WPIRoboticsProjects/Lionfish-AcousticLink/readme.md

This is the repo for acoustic modem and localization from acoustic modem
