WPIRoboticsProjects/Lionfish-AcousticLink/TransPowerCalculation/Marsh and Schulkin absorbation.png

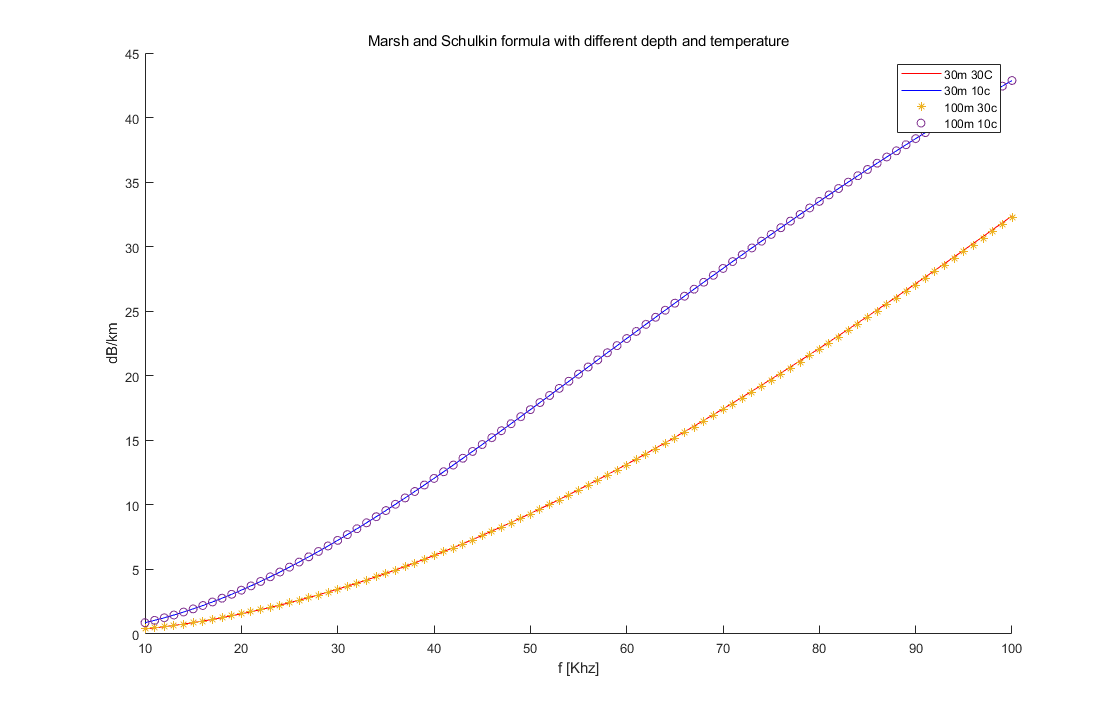
TransPowerCalculation/Marsh and Schulkin absorbation.png
