WPIRoboticsProjects/Lionfish-AcousticLink/TransPowerCalculation/Spread loss.png

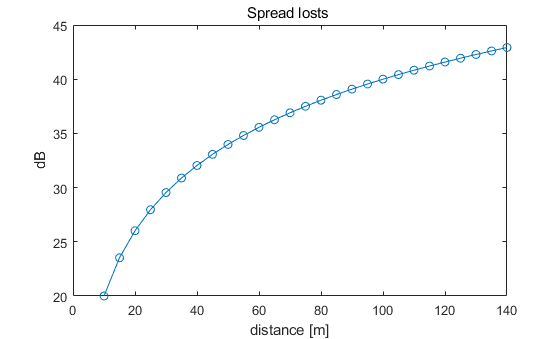
TransPowerCalculation/Spread loss.png
