WPIRoboticsProjects/Lionfish-AcousticLink/TransPowerCalculation/Thorp formula.png

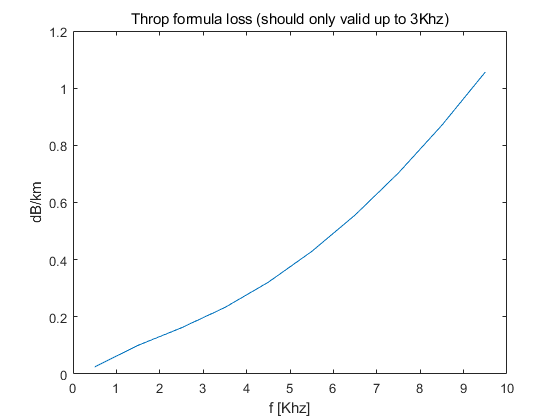
TransPowerCalculation/Thorp formula.png
