WPIRoboticsProjects/Lionfish-AcousticLink/Measurements/Batt flyback nosie.docx

Added highlighted part for gate protection and battery noise filtering.

(gate protection will not work unless there are no spikes in battery voltage).

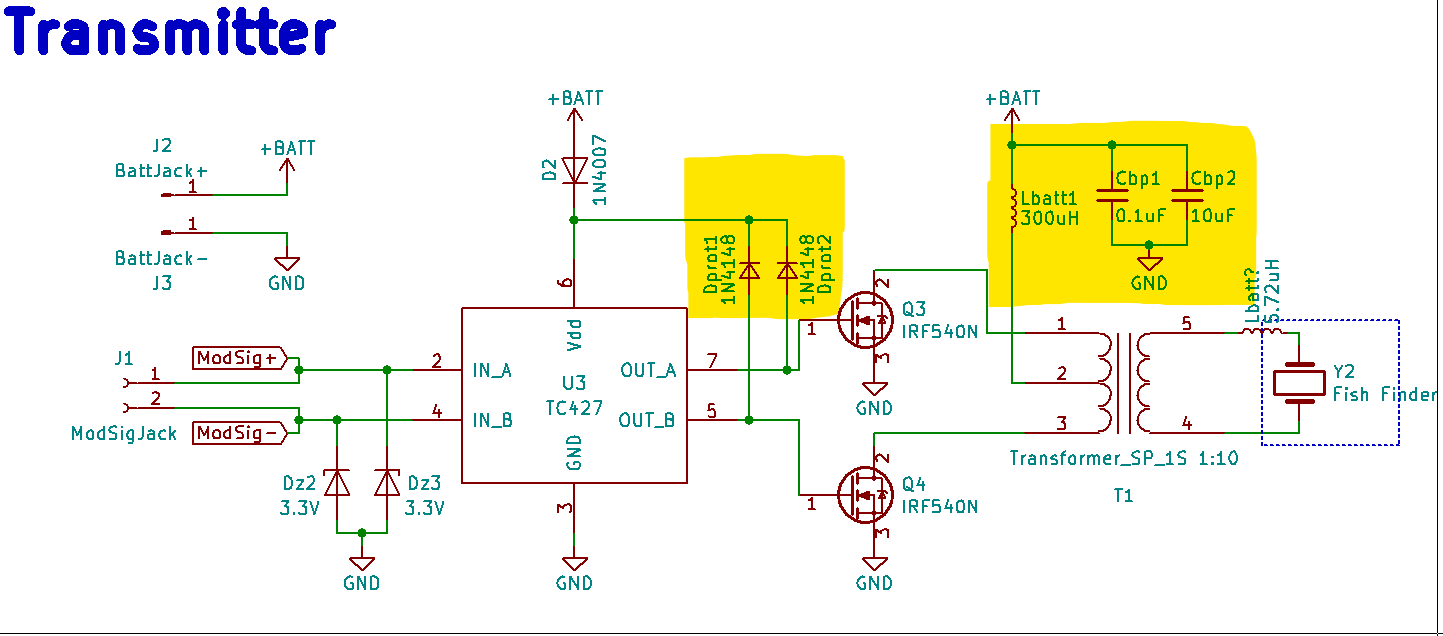
[picture p4: figure]
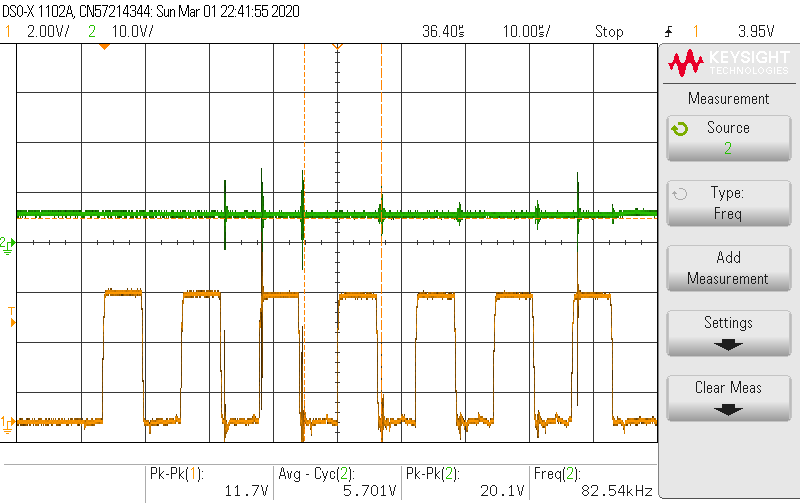
[picture p5: figure]

Orange: Voltage at Gate:

Green: Power supply voltage.
