WPIRoboticsProjects/Lionfish-AcousticLink/Measurements/200Khz HF ring.docx

Driving the setup using Arduino with 5V, 200Khz.

Ch1 is across half a transformer coil, Ch2 is fish finder output

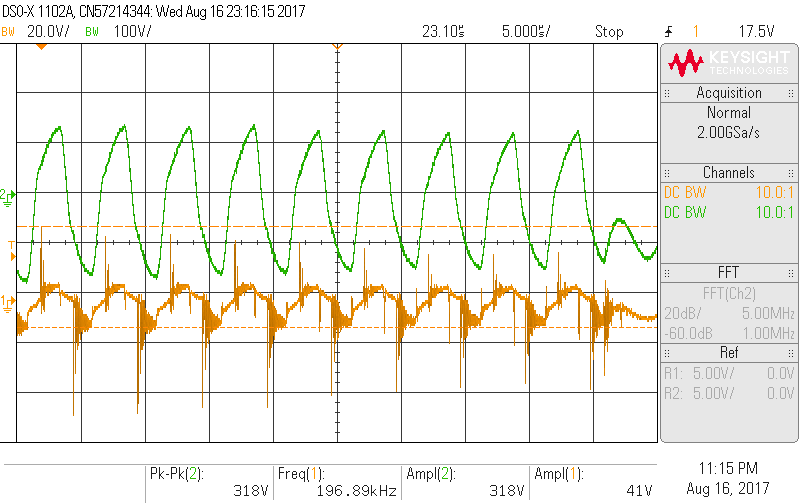
[picture p6: figure]

Zoom in on ring of transformer.

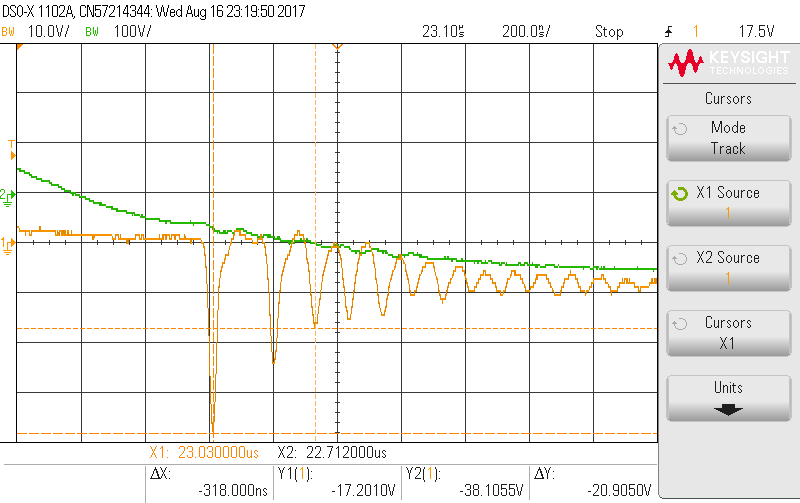
[picture p7: figure]
