WPIRoboticsProjects/Lionfish-AcousticLink/Measurements/Transistor LevelShift fail.docx

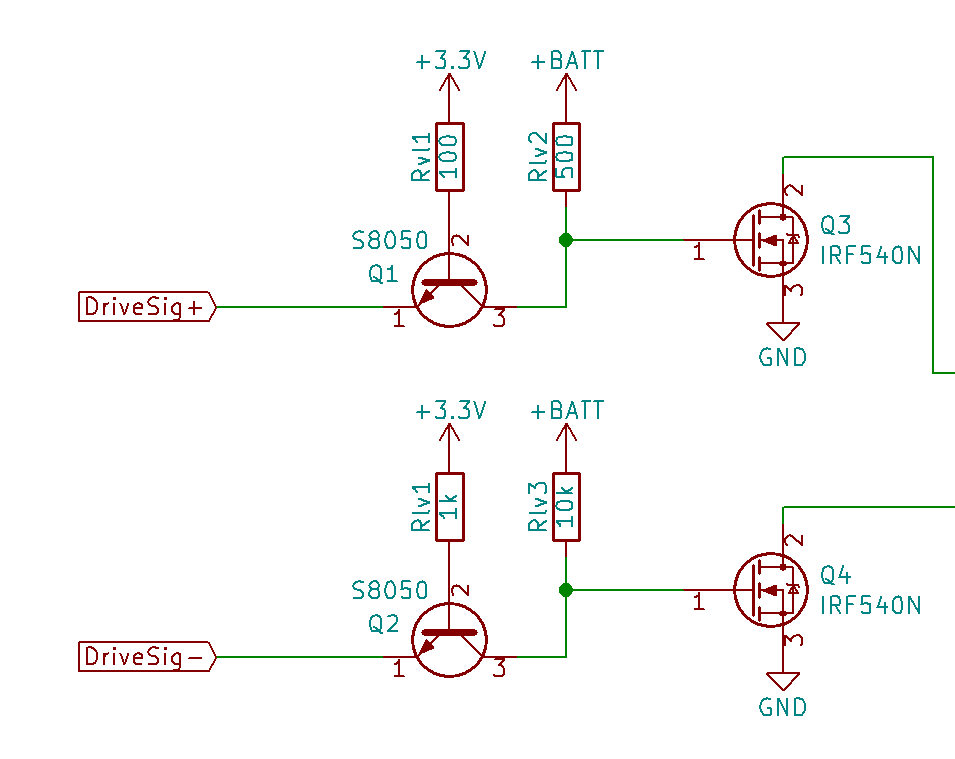
[picture p17: figure]
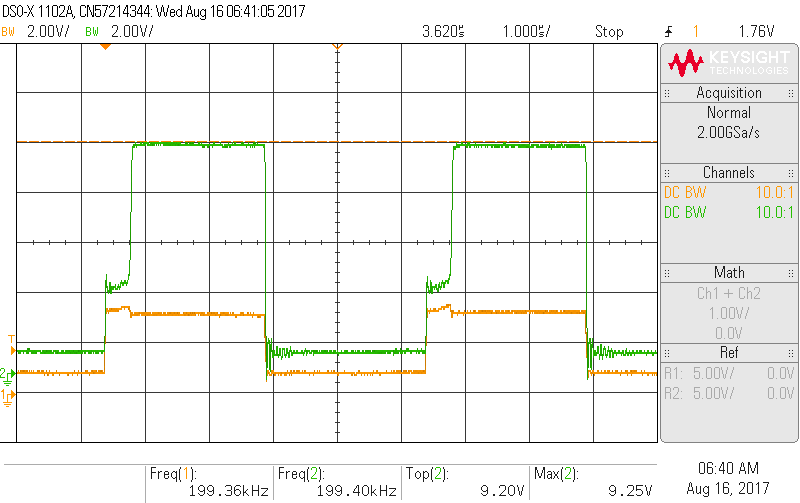
[picture p18: figure]

Notice the 0.6us delay before turn on

When MOSFET is connected (MOSFET is not driving anything)

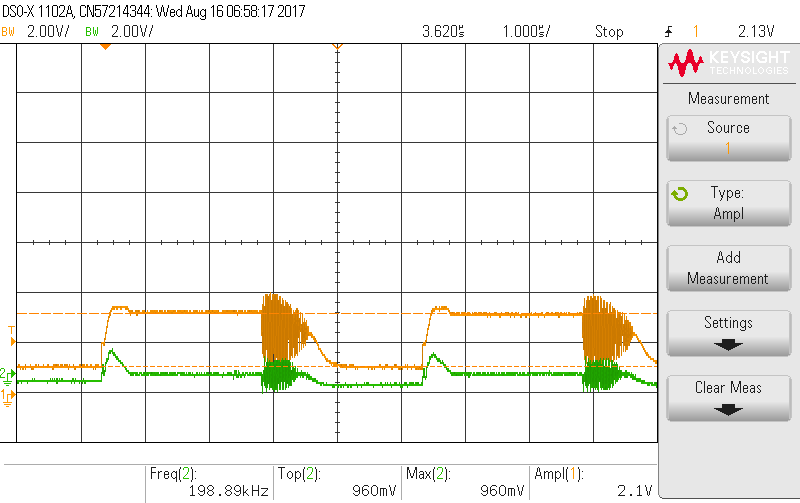
[picture p19: figure]
