WPIRoboticsProjects/Lionfish-AcousticLink/Measurements/Amplifiers/Amplifier Noise.docx

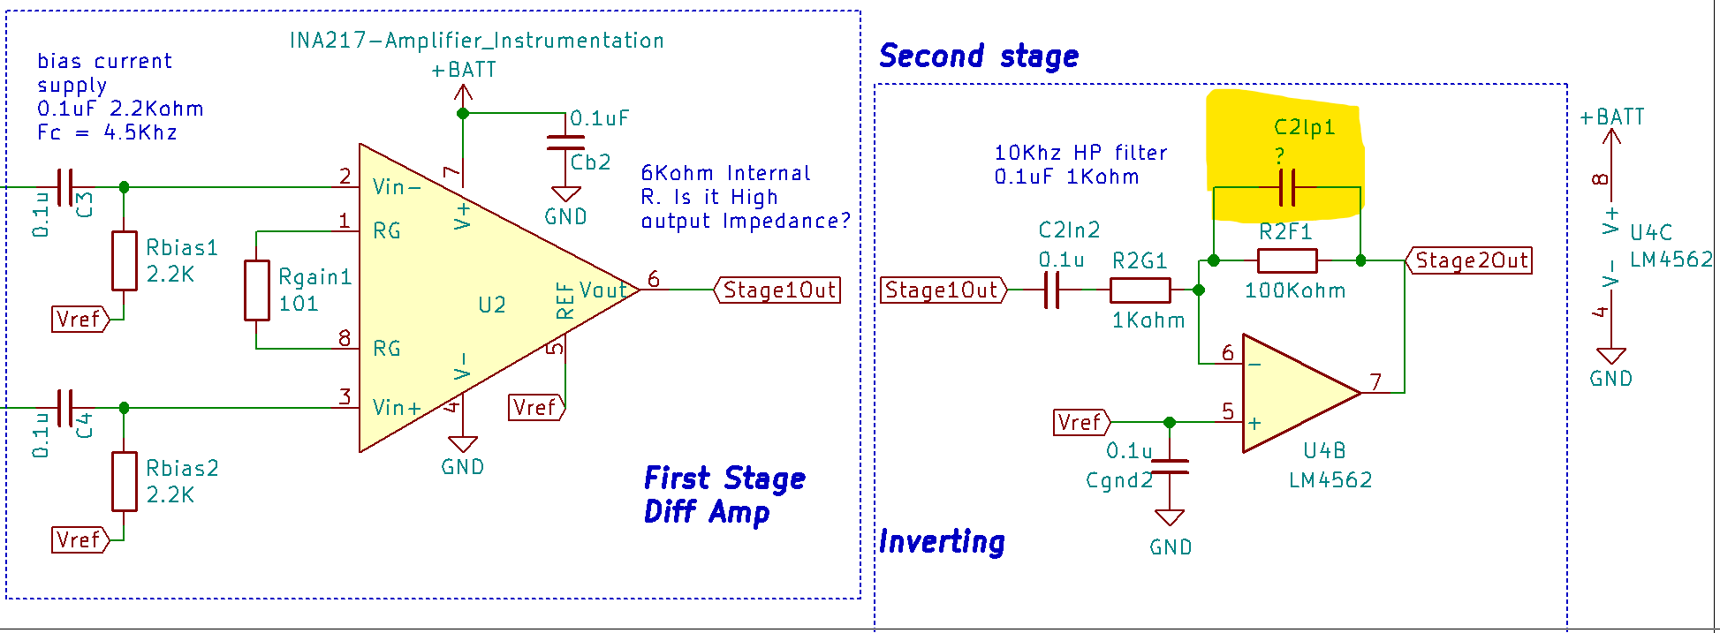
[picture p20: figure]

The first waveform is without C2lp1 cap

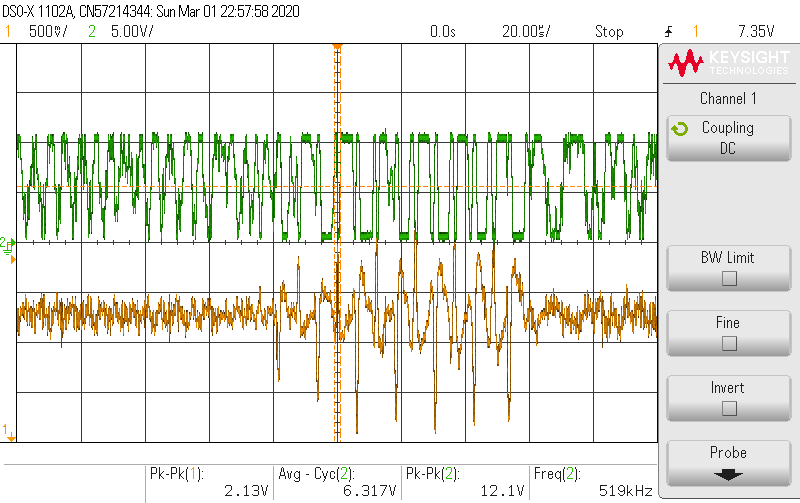
[picture p21: figure]

Orange: first stage output,

Green: second stage output.

The signal is still noticeable as they are fully saturated. But only to human eyes.

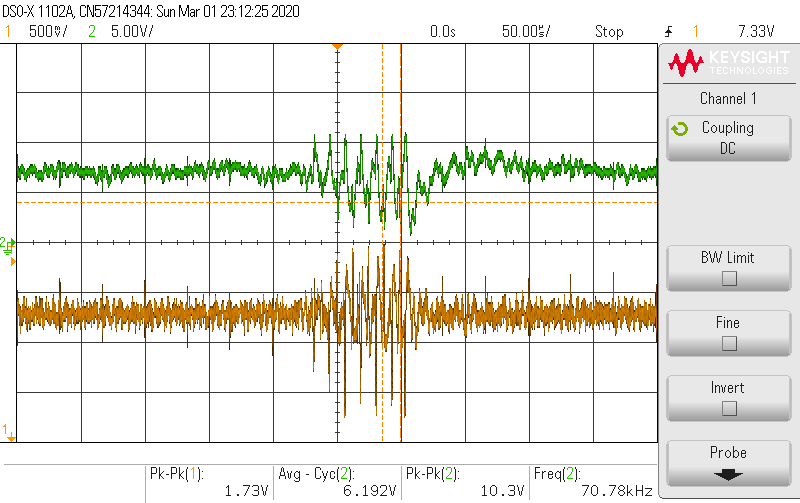
[picture p22: figure]

With C2lp1 = 100pF.

The noise is suppressed (not much), but the output signal is also suppressed by 10 times. (suppose to be 100 times gain).
