WPIRoboticsProjects/Lionfish-AcousticLink/Measurements/Powersupply/Transient Flyback Batt.csv

x-axis | 1 | 2
second | Volt | Volt
-61.600E-06
-61.500E-06 | -49.245978E-03 | +5.910804018E+00
-61.400E-06 | -69.346480E-03 | +5.910804018E+00
-61.300E-06 | -39.195727E-03 | +5.920854270E+00
-61.200E-06 | -39.195727E-03 | +5.991206028E+00
-61.100E-06 | -69.346480E-03 | +5.940954772E+00
-61.000E-06 | -39.195727E-03 | +5.961055274E+00
-60.900E-06 | -69.346480E-03 | +5.830402009E+00
-60.800E-06 | -39.195727E-03 | +5.910804018E+00
-60.700E-06 | -19.095224E-03 | +5.910804018E+00
-60.600E-06 | -69.346480E-03 | +5.739949749E+00
-60.500E-06 | -69.346480E-03 | +5.729899498E+00
-60.400E-06 | -69.346480E-03 | +5.830402009E+00
-60.300E-06 | -99.497234E-03 | +5.910804018E+00
-60.200E-06 | -99.497234E-03 | +5.961055274E+00
-60.100E-06 | -49.245978E-03 | +5.910804018E+00
-60.000E-06 | -69.346480E-03 | +5.830402009E+00
-59.900E-06 | -19.095224E-03 | +5.910804018E+00
-59.800E-06 | -39.195727E-03 | +5.860552763E+00
-59.700E-06 | -39.195727E-03 | +5.910804018E+00
-59.600E-06 | -99.497234E-03 | +5.910804018E+00
-59.500E-06 | -39.195727E-03 | +5.910804018E+00
-59.400E-06 | -69.346480E-03 | +5.910804018E+00
-59.300E-06 | -19.095224E-03 | +5.910804018E+00
-59.200E-06 | -39.195727E-03 | +5.880653265E+00
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
