WPIRoboticsProjects/Lionfish-AcousticLink/TransPowerCalculation/Impedance Cal/Fish and coil Impedance Measure.xlsx

Sheet: Fish Finder Impedance
Fig 1 Circuit |  |  |  | Voltage -> current phase
Feq (Khz) | Vfish (Prob2-Gnd) Vpp (V) | Vr (Prob1-Prob2) Vpp | Current (Vr/R) (A) | Vfish -> Ifish angle (deg) | V/I | Re{z} | Im{z}
300 | 3.47 | 8.72 | 0.00872 | -89.2 | 397.936 | 5.557 | -397.897
250 | 4.3 | 7.95 | 0.00795 | -80.1 | 540.881 | 92.994 | -532.826
225 | 4.362 | 8.15 | 0.00815 | -86.1 | 535.215 | 36.403 | -533.975
210 | 4.58 | 7.074 | 0.007074 | -71.1 | 647.441 | 209.718 | -612.535
205 | 3.956 | 7.411 | 0.007411 | -69.5 | 533.801 | 186.942 | -499.996
200 | 3.77 | 7.93 | 0.00793 | -75.52 | 475.410 | 118.873 | -460.308
195 | 4.139 | 8.074 | 0.008074 | -82.7 | 512.633 | 65.138 | -508.478
190 | 4.404 | 7.969 | 0.007969 | -83.8 | 552.641 | 59.686 | -549.409
175 | 4.71 | 7.88 | 0.00788 | -84.09 | 597.716 | 61.545 | -594.539
150 | 5.7 | 7.53 | 0.00753 | -83.88 | 756.972 | 80.703 | -752.658
130
120 | 6.21 | 7.08 | 0.00708 | -84.46 | 877.119 | 84.679 | -873.022
110
100 | 7.38 | 6.01 | 0.00601 | -87.5 | 1227.953 | 53.564 | -1226.785
90 | 8.01 | 4.89 | 0.00489 | -84.58 | 1638.037 | 154.724 | -1630.713
85 | 8.28 | 3.79 | 0.00379 | -76.76 | 2184.697 | 500.365 | -2126.625
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
