WPIRoboticsProjects/Lionfish-AcousticLink/Measurements/100 10K Rtrans .jpg

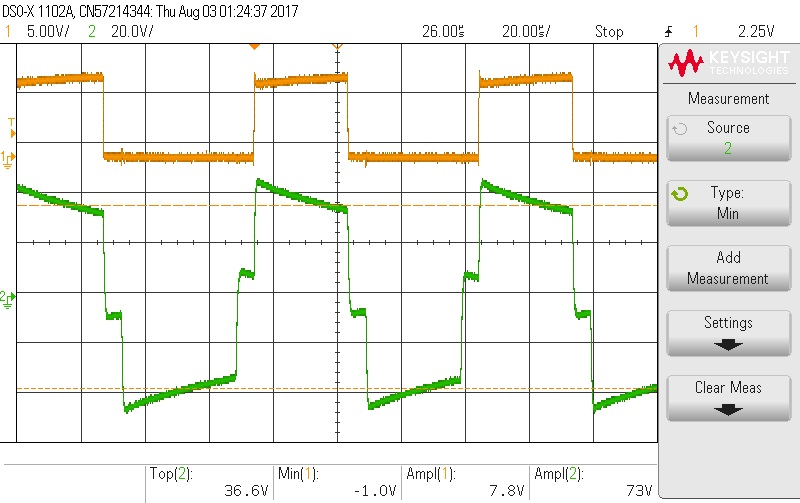
Measurements/100 10K Rtrans .jpg
