WPIRoboticsProjects/Lionfish-AcousticLink/Measurements/100 100K real trans.jpg

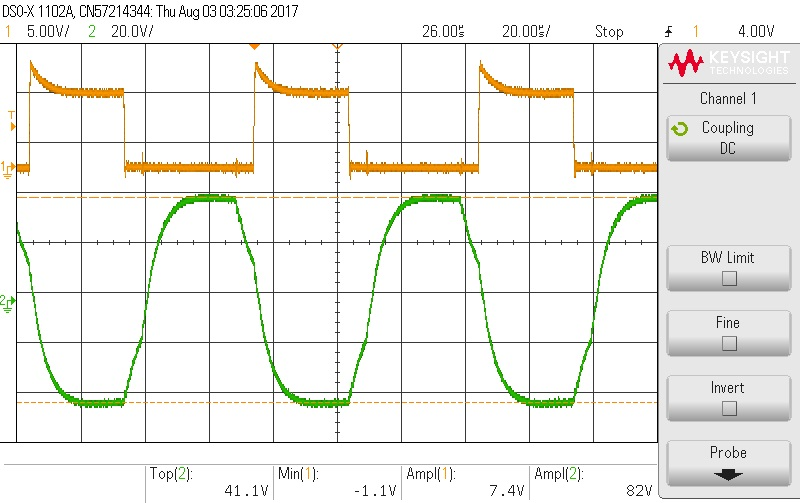
Measurements/100 100K real trans.jpg
