WPIRoboticsProjects/Lionfish-AcousticLink/Measurements/100 100K Rtrans.jpg

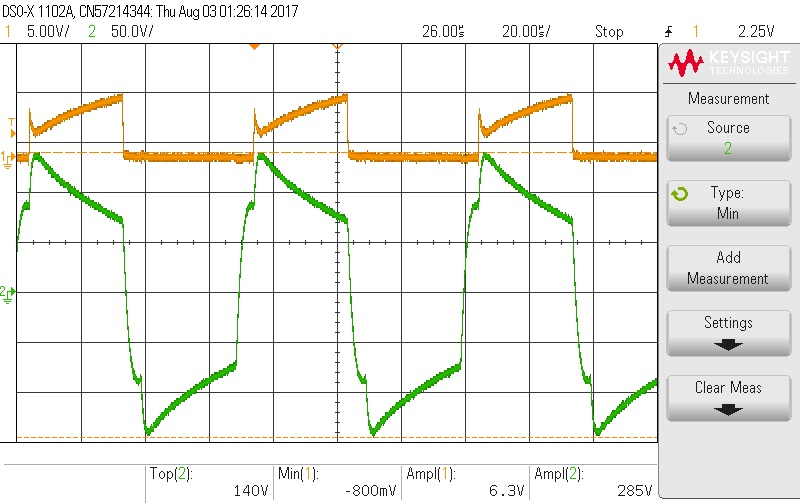
Measurements/100 100K Rtrans.jpg
