WPIRoboticsProjects/Lionfish-AcousticLink/TransducerDriver/TransReceiver.pdf

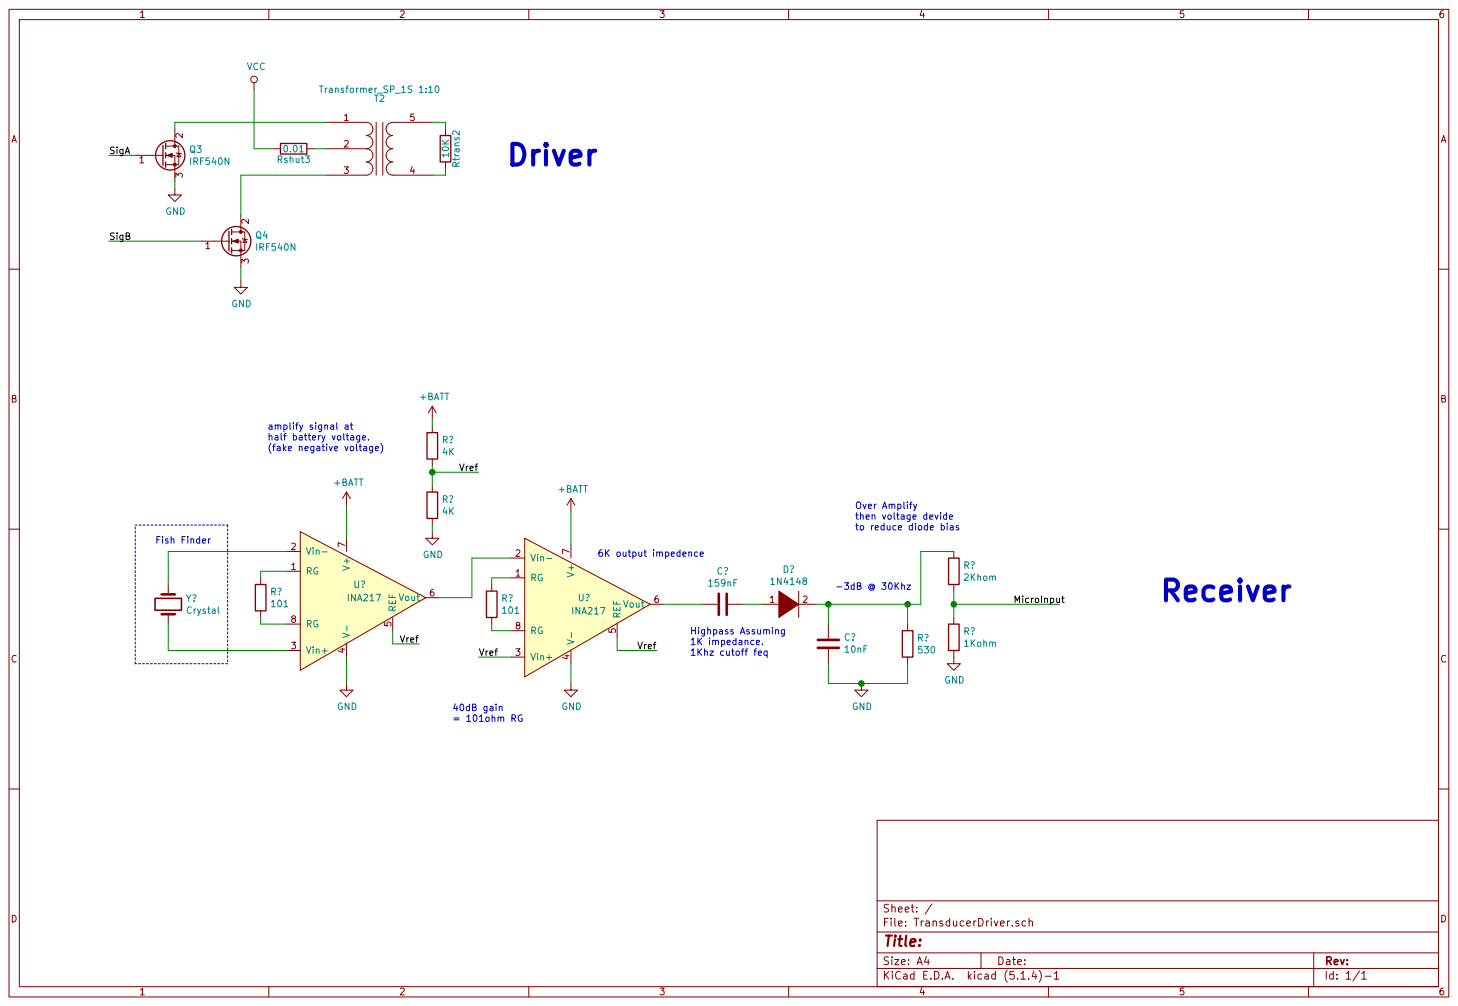
[picture p26: page 1]

Vref Vref Vref SigB
4K GND

Id: 1/1 Title: File: TransducerDriver.sch Sheet: / R?

6K output impedence Fish Finder
