WPIRoboticsProjects/Lionfish-AcousticLink/(list of files, drawings)

Other design files:
TransducerDriver/Clamper.ms14
TransducerDriver/Envelop Detector/EnvelopDetector Simulation.ms14
