WPIRoboticsProjects/Lionfish-AcousticLink/TransducerDriver/TransducerDriver.kicad_pcb

## KiCad design TransducerDriver/TransducerDriver.kicad_pcb (2020-02-15)

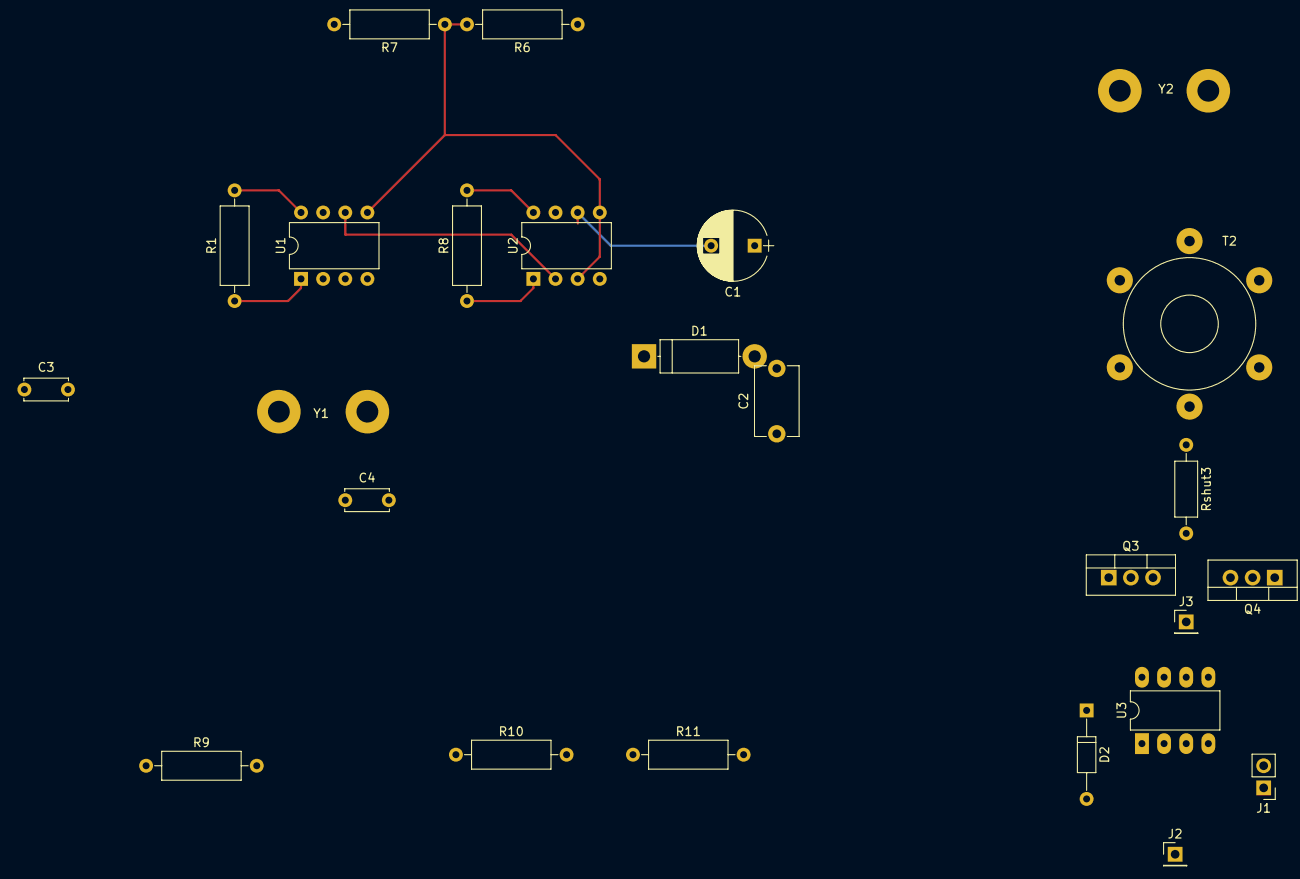
[picture p27: board TransducerDriver.kicad_pcb from above]

Board: 2 copper layers, 25 parts (0 on the bottom side), 26 nets.

Parts:
C1: 159nF; CP_Radial_D8.0mm_P5.00mm
C2: 10nF; C_Disc_D8.0mm_W5.0mm_P7.50mm
C3, C4: 0.1u; C_Disc_D5.0mm_W2.5mm_P5.00mm
D1: 1N4148; D_5W_P12.70mm_Horizontal
D2: 1N4007; D_DO-35_SOD27_P10.16mm_Horizontal
J1: ModSigJack; Pin_Header_Straight_1x02_Pitch2.54mm
J2, J3: BattJack; Pin_Header_Straight_1x01_Pitch2.54mm
Q3, Q4: IRF540N; TO-220-3_Vertical
R1, R8: 101; R_Axial_DIN0309_L9.0mm_D3.2mm_P12.70mm_Horizontal
R6, R7: 4K; R_Axial_DIN0309_L9.0mm_D3.2mm_P12.70mm_Horizontal
R9: 530; R_Axial_DIN0309_L9.0mm_D3.2mm_P12.70mm_Horizontal
R10: 2Khom; R_Axial_DIN0309_L9.0mm_D3.2mm_P12.70mm_Horizontal
R11: 1Kohm; R_Axial_DIN0309_L9.0mm_D3.2mm_P12.70mm_Horizontal
Rshut3: 0.01; R_Axial_DIN0207_L6.3mm_D2.5mm_P10.16mm_Horizontal
T2: Transformer_SP_1S 1:10; Transformer_Toroid_Tapped_Horizontal_D14.0mm_Amidon-T50
U1, U2: INA217; DIP-8_W7.62mm
U3: TC427; DIP-8_W7.62mm_LongPads
Y1, Y2: Crystal; WireConnection_2.50mmDrill

Connections:
+BATT: D2.2, J2.1, R6.1, Rshut3.2, U1.7, U2.7
/MicroInput: R10.2, R11.1
/Vref: R6.2, R7.1, U1.5, U2.3, U2.5
GND: C2.1, J3.1, Q3.3, Q4.3, R7.2, R9.2, R11.2, U1.4, U2.4, U3.3
ModSig+: J1.1, U3.2
ModSig-: J1.2, U3.4
unnamed: C1.1, D1.1
unnamed: C1.2, U2.6
unnamed: C2.2, D1.2, R9.1, R10.1
unnamed: C3.1, U1.2
unnamed: C3.2, Y1.1
unnamed: C4.1, U1.3
unnamed: C4.2, Y1.2
unnamed: D2.1, U3.6
unnamed: Q3.1, U3.7
unnamed: Q3.2, T2.1
unnamed: Q4.1, U3.5
unnamed: Q4.2, T2.3
unnamed: R1.1, U1.1
unnamed: R1.2, U1.8
unnamed: R8.1, U2.1
unnamed: R8.2, U2.8
unnamed: Rshut3.1, T2.2
unnamed: T2.4, Y2.2
unnamed: T2.5, Y2.1
unnamed: U1.6, U2.2
