WPIRoboticsProjects/Lionfish-AcousticLink/ArmTransceive/pwmDriver.h

/*
 * pwmDriver.h
 *
 *  Created on: 2020��2��3��
 *      Author: leogr
 */

#ifndef PWMDRIVER_H_
#define PWMDRIVER_H_

void pwm1Init();
void pwm3Init();
void pwmPinInit();
void pwmOutputEnable();
void pwmOutputDisable();

void TXdebugPinSet(uint8_t data);
void TXdebugPinInit();

void PWM_ISR_FUNC(void);



#endif /* PWMDRIVER_H_ */
