WPIRoboticsProjects/Lionfish-AcousticLink/ArmTransceive/TimerTX.h

/*
 * TimerTX.h
 *
 *  Created on: 2020Äê2ÔÂ23ÈÕ
 *      Author: leogr
 */

#ifndef TIMERTX_H_
#define TIMERTX_H_


void t1OF_ISR();
void timer1Init();



extern uint16_t t1OFCount ;


#endif /* TIMERTX_H_ */
