WPIRoboticsProjects/Lionfish-AcousticLink/(commit log)

2019-10-29 Made waveform gen for any sample rate and base frequency
2019-11-07 created Matlab calculation for transmission loss, and attached figure for result from different method
2019-11-07 added design for switching battery
    [BatRelay.kicad_pcb, BatRelay.sch]
2019-11-07 added ESD zener for MOSFET design
    [BatRelay.sch]
2019-11-07 Revert "Merge branch 'master' of https://github.com/LionfishMQP/AcousticLink"
    This reverts commit a923de0f6f5281807e581be3a9d295d99ad474c0, reversing
    changes made to ccfcc6052f2c2148d2317a675659a02fa5cdc53d.
    [BatRelay.kicad_pcb, BatRelay.sch]
2019-11-07 Revert "Revert "Merge branch 'master' of https://github.com/LionfishMQP/AcousticLink""
    This reverts commit bcc0f9a52feea505232c62d8da3853226641cb11.
    [BatRelay.kicad_pcb, BatRelay.sch]
2019-11-12 added design for distributed power cycle
    [BatRelay.kicad_pcb, BatRelay.sch, PowerDistribution.kicad_pcb, PowerDistribution.sch]
2019-11-30 created basic decoding file, and added csv write to matlab
    [processedSamples.csv, samples.csv]
2019-12-03 OOK Modulation + Cleanup
    Added modulation + writing to csv in encode.c
    Organized python and c file folders
    [encode_payload.csv, encoded_payload.csv]
2019-12-04 finished ook modulation to csv
    [encode_payload.csv, encoded_binary.csv, encoded_payload.csv, modulated_binary.csv]
2019-12-04 encode fix
    [encoded_binary.csv, modulated_binary.csv]
2019-12-04 new SAMPLE_RATE
    [encoded_binary.csv, modulated_binary.csv]
2019-12-05 changed filter range
2019-12-09 fixes + settings (WIP)
    [modulated_binary.csv, processedSamples.csv, settings.csv]
2020-02-03 PWM driver on arm board, transducer circuit
    [BatRelay.kicad_pcb, BatRelay.sch, PowerDistribution.kicad_pcb, PowerDistribution.sch, TransducerDriver.kicad_pcb, TransducerDriver.sch]
2020-02-10 changes
    sampling adc + buttons
2020-02-15 updates
    compiles for me now, added support for buttons and sampling .c
2020-02-15 studies on transducer
    [Fishfinder Impedance Measure.xlsx, TransducerDriver.kicad_pcb, TransducerDriver.sch]
2020-02-16 small change on InsAmp. Input pull to vref
    [TransducerDriver.sch]
2020-02-18 rough structure for processing ADC RX
2020-02-19 more impedance data
    [Fish and coil Impedance Measure.xlsx, Fishfinder Impedance Measure.xlsx, _saved_TransducerDriver.sch]
2020-02-19 impedance calculation done
    [Fish and coil Impedance Measure.xlsx, TransducerDriver.sch, _saved_TransducerDriver.sch]
2020-02-23 more calculation
    [Fish and coil Impedance Measure.xlsx, TransducerDriver.sch]
2020-02-24 added timer files
    [Fish and coil Impedance Measure.xlsx]
2020-02-25 trying to add timer1, but get system fault
2020-02-25 CRC + DMA clean up
    Changes for CRC, and DMA clean up
2020-02-28 todo list for help
    need help with PWM and Ethernet ISR setup
2020-02-29 more mod on circuits
    [TransducerDriver.sch]
2020-03-02 more measurement and update schematic
    [TransducerDriver.sch]
2020-03-02 Ethernet + Timer Fix
    [ALinkProtocol.h, Ethernet.c, Ethernet.h, TimerTX.c, main.c, sampling.c]
2020-03-02 more measurement and schmatic update
    [TransducerDriver.sch]
2020-03-03 timer1 work, and is read to trigger ADC as well
2020-03-03 transmit works now. It will clock the PWM out according to data it get
2020-03-03 changed ADC (no DMA)
2020-03-04 small changes
    construct packet was failing because of weird int type issues
    [Process_TX.c, main.c]
2020-03-25 sampling problems
    Will sample up to 9 or so bits into raw_rx but will not read whole packet. problem with bit xor or read_for
    [Process_RX.c]
2020-04-21 Revert "more merge changes"
    This reverts commit 9ff77436987e17026d60a138173b1d5c7bb23e4e.
    [ALinkProtocol.c, Process_RX.c, TimerTX.c, TimerTX.h, main.c, pwmDriver.c, pwmDriver.h, sampling.c]
2020-04-21 Revert "cleanup"
    This reverts commit cc72b08c53214a4f9a6eb29a68c55144737209b3.
    [ALinkProtocol.c, ALinkProtocol.h, Process_RX.c, Process_TX.c, main.c]
2020-04-21 Revert "rx / tx full merge"
    This reverts commit 94f6001b4b1806fa120cbfeac09636d83672bcb4.
    [ALinkProtocol.c, ALinkProtocol.h, CRC.c, Process_RX.c, Process_TX.c, sampling.c]
2020-05-18 final clean up
    [Clamper.ms14, EnvelopDetector Simulation.ms14, Fish and coil Impedance Measure.xlsx, TransducerDriver.sch, Transient Flyback Batt.csv]
